QianLabUSC/ODrive/README.md

# 1. ODRIVE BASIC SETUP:
refer to `odrive-setup.md` for complete odrive setup guide
# 2. CAD FILES:
CAD files for U8ii motor and AS5048A/AS5047P encoders included in this folder
# 3. ODRIVE SCRIPTS:
`Teensy_Scripts` contains movement scripts for odrive boards run through a Teensy microcontroller
