QianLabUSC/ODrive/Config Backups/README.md

# Configs
A Collection of ODrive Board Configuration Backups.
Just in case a board gets fried.

Board config is dumped via command `odrivetool backup-config`.
