QianLabUSC/ODrive/CAD Files/Base plate for encoder mount (for motor enclosure).SLDPRT

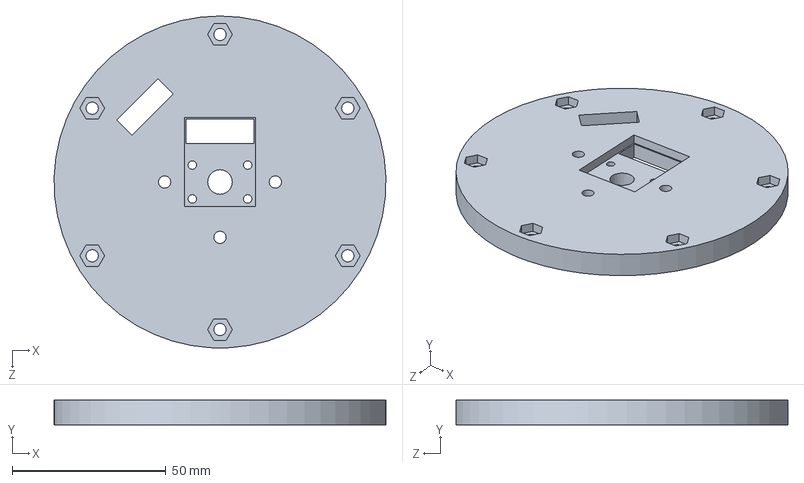
[picture p1: CAD file, 2021-05-22]
CAD Files/Base plate for encoder mount (for motor enclosure).SLDPRT
108.0 x 8.00 x 108.0 mm
