QianLabUSC/ODrive/CAD Files/encoder mount for aluminum extrusion.SLDPRT

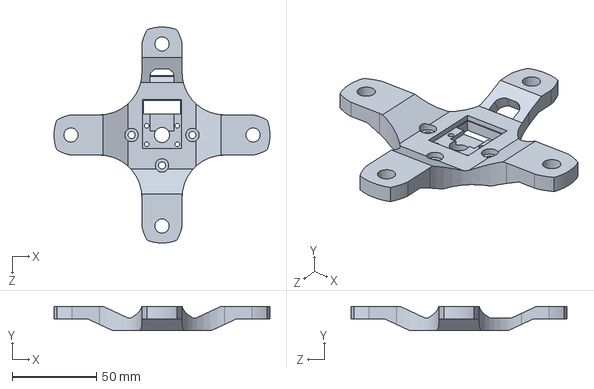
[picture p2: CAD file, 2021-05-22]
CAD Files/encoder mount for aluminum extrusion.SLDPRT
127.8 x 14.5 x 127.8 mm
