QianLabUSC/ODrive/images/encoder_assembly.jpg

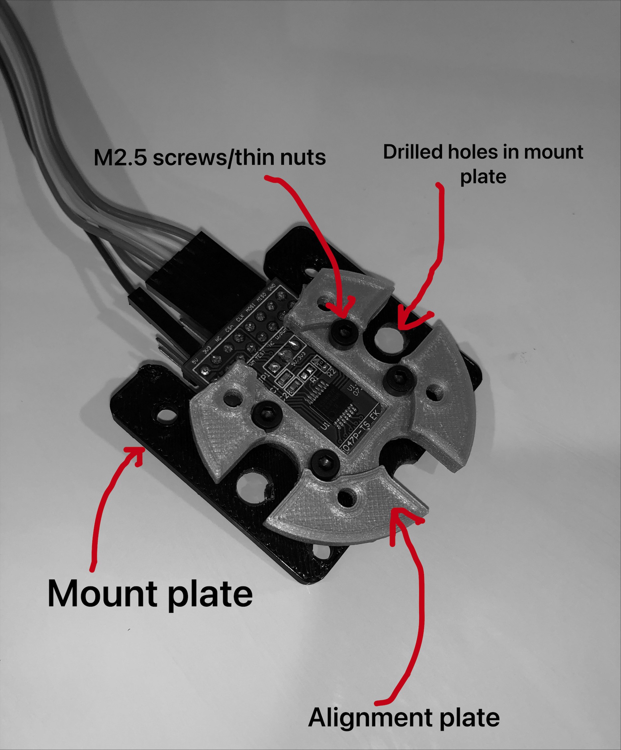
images/encoder_assembly.jpg
