QianLabUSC/ODrive/(commit log)

2021-04-05 added Teensy scripts
2021-05-22 updated documentation for new encoder
    [Base plate for encoder mount (for motor enclosure).SLDPRT, encoder mount for aluminum extrusion.SLDPRT]
2021-05-28 "fixed functionality. fuck c++"
    [TorqueHelpers.cpp, main.cpp]
2021-05-29 fix typo in code
    [main.cpp]
2021-05-29 print ref angle
2021-05-31 switch activation letter
2021-06-01 debugging printouts
2021-06-01 update current change
2021-06-01 update mode to filtered
    may not be working
2021-06-10 updated odrive build docs
2021-06-10 updated documentation for brake resistance and regen current
2021-06-11 restore calibration
2021-06-11 Create U8II Calibration.md
2021-06-11 dump calibrate in lib
2021-06-11 restructure into switch case
2021-06-18 bump to 2 motors
2021-06-22 reduce current lim
2021-06-22 update backup with reduced current lim
2021-07-16 do not wait for calibration to complete
2021-07-31 Added kinematics and basic test script
2021-08-05 set up test code for 2 motors
2021-08-05 fix hard coded axes
    [ODriveState.cpp]
2021-08-05 set up leg config
2021-08-05 remove old Leg Config thing
2021-08-05 define leg enum
2021-08-05 switch test gait
2021-08-12 use hardware serial 2 instead
    works together with Teensy pins 9 and 10
2021-09-10 attempt to drive 2 legs together
2021-09-24 fix calibration issue
2021-10-21 leg kinematics implemented
2021-10-21 changed calibration mode variable in LegConfig.cpp
2021-10-29 added E-Stop function. Bux fixes. Updated bounds
    [LegConfig.cpp, LegConfig.hpp, PositionControl.cpp, PositionControl.hpp, main.cpp]
